Dougal121/Solar/README.md

# Solar
Solar Tracker projects

All these files are supplied as is and are to be used at your own risk.
If in doubt you should seek independent engineering advice as to the suitabilty of desgins before you build anything.
