Dougal121/Solar/Thermal_Controller/ReadMe.md

ESP8266 Controller For Evacuated Tube Thermal Solar Heaters<br>(circa Nov 2020 - 2021 )
===========================================================

Has email warnings and web interface.

15/11/2020 Almost working - hardware a few days off arrival<br>
16/03/2021 The pump relays, Open weather and Email going  <br>
           Yeah Almost fully working - working on modes for predictive boost<br>
27/03/2021 I think it be working... all the components seem almost sorta right<br>
