Dougal121/Solar/ESP8266_Tracker/SecondCut/ReadMe.txt

Second cut with OTA works ok but could be better...

08/05/2019 (in the wee hours)
Assuming I havent broken to many things since my last test this should be close to whats running in the feild and very close to whats running on the spare unit sitting beside me on the sofa
