Dougal121/Solar/(threads)

Thread 1 (2020-06-30):

Try to check standalone esp test

dawidqs, 2020-06-30:
Hi
I got bootloop with 3rd cut esp 8266 code. I'm only preconfigure ssid and password, ESP connect for while to AP, disconnect, do the configure AP for few secs and reboot.

Log with first error:

WiFi connected
IP address: 192.168.043.165
NTP Local UDP port: 2390
Control Local UDP port: 8666
HTTP server started
Fatal exception 9(LoadStoreAlignmentCause):
epc1=0x40215617, epc2=0x00000000, epc3=0x00000000, excvaddr=0x3ffefc6b, depc=0x00000000

Exception (9):
epc1=0x40215617 epc2=0x00000000 epc3=0x00000000 excvaddr=0x3ffefc6b depc=0x00000000

My conf:
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

Dougal121, 2020-07-01:
I assume you have done an "eeprom save" after the first factory reset ?
This is sort of a catch all ... but it should do this on the very first boot ?
If it doesn't connect to your client AP you should be able to access it from the softAP to test and configure everything else ?

Hmm running on 2.7.1   (last time I tested this was 2.4.1)
I will check and see if that is the issue. Have already had another issue with 2.7.1 BUT I know that user is getting past boot as his issue was in the OTA upload.

dawidqs, 2020-07-01:
Hello
Thank you for answer.
I get the email from error on first boot after flashing by arduino ide. I
can't do enything in Web settings during loop, after connect it's pingable
only for few seconds. On 2nd cut this hardware on same settings Web
interface works well.
This is my first steps with this project. I got only ESP from my stuff and
will buy rest items after some tests with it. I may forfeit the led, lcd
displays and gps modules.

Śr., 1 lip 2020, 02:46 użytkownik Dougal Plummer <notifications@github.com>
napisał:

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

Dougal121, 2020-07-02:
YES it will run without everything... ie the bare ESP should be OK
I have a picture with a naked ESP32 board running the code connected to nothing but its inbuilt OLED display (the display is write only so it runs without that as well).

I may need to flash a virgin board to check the results you are seeing with 2.7.1

Stick to the third cut of the code as it is the only one kept up to date. And there are some issues in the older versions that took a lot of time to find and remove.

ans-gw, 2022-06-23:
Hi,
I m trying this new V3 Giune 2022,but got compile error :
exit status 1
'class ESPMail' has no member named 'addBCC'

Page "Email.ino": line 92-94:

if ( String(SMTP.BCC).length() > 5 ){
        WDmail.addBCC(SMTP.BCC );
      }

- I cancel line 92-94(for try) and scetch will compile and upload and run into Esp8266 Nodemcu32.
- I can connect wifi ,access menu ecc.
I dont know which are the conseguence of cancel line  92-94!!!
Please take a look.

Thank you...good job,really.
I actually use Esp32 version wth gyro and Rtc module and all works ok.
Glad to see you fix Noed Emisphere...i load it jesterday and work ok.

-

Dougal121, 2022-06-24:
You need to add the ESPMail lib to your ardudino IDE ?
I will lookup the version number and put details up tonight if time permits

ans-gw, 2022-06-24:
Hi,
I add already Espmail.
Compile error is:
"exit status 1
'class ESPMail' has no member named 'addBCC'"

I google it and i find should be "AddBCC"...instead of "addBCC"...i tryed but get compile error.

If I cancel from Page "Email.ino" line 92-94,sketch compile Ok ,can upload it to Esp8266 Nodemcu.
"if ( String(SMTP.BCC).length() > 5 ){
WDmail.addBCC(SMTP.BCC );
} "

Unfortunatelly,I no have the knowledge,to solve it.

Thank you for help.

ans-gw, 2022-07-03:
> You need to add the ESPMail lib to your ardudino IDE ? I will lookup the version number and put details up tonight if time permits

Now its working fine.Thanks for tip.
Why no have anymre GPIO settint on web interface?
Can you kindly explain wind speed sorce?
0 ADC-A0; 1 Other Tracker; 2 Open weather

Thanks you

ans-gw, 2022-07-04:
Today i was testing the system and I notice a problem:
After a loss of power,Esp8266 rebooted and get Time from Ntp server,so started calculation and turn on 1 Est relay...
but gyro was not installed and this cause East relay never torn off!
Very dangerous...fortunatelly i was testing on the workbench!

ans-gw, 2022-07-05:
......Huoston ,we have a problem!!!
Pin D8 can not be used on My ESP8266 Nodemcu !
If i start power on Esp8266 with Pin D8 connected....Esp will not boot.
If i plug pin D8 after boot ALL is Ok.
How to do?
Have free GPIO10 and GPIO9,but if i try to change here,I have error compile:
Pin was not declared for this scope.
const byte RELAY_XZ_PWM = **D8 to GPIO10**; // PWM 1    Speed North / South     Was the X- S relay  Orange
const byte RELAY_YZ_PWM = D5; // PWM 2    Speed East / West       Was the Y+ W relay  Blue
const byte RELAY_YZ_DIR = D6; // DIR 2    Y+ Y- East / West       Was the Y- E relay  Yellow
const byte RELAY_XZ_DIR = D7; // DIR 1    X+ X-  North / South    Was the X+ N relay  Brown

With Esp32 version was easy,as con change pins from web interface...

Thanks for help.

Dougal121, 2022-07-06:
Sorry been very busy.
Yes system does require sensors and limit switches for travel. In my case these are built into the unit actuators and give another level of protection should the computer go mad.
Yes only some of the pins on the ESP8266 can be used on relay boards... It stops the CPU booting ... Yes use another pin
Ummm to use pin GPIO10  just put in "10" ? The "D" designations don't always work unless your using EXACTLY the branded board.  I often resort to writing a simple blink program to toggle pins then go looking for them with a meter, this checks my declarations.
Yes on the ESP32 I added a this to the web interface but you didn't really get a choice on the ESP8266 as it has only exactly the correct number of pins... esp32 has MORE than enough

Dougal121, 2022-07-06:
I will get back on this shortly but I have to finish some paid work first unfortunately

ans-gw, 2022-07-07:
> I will get back on this shortly but I have to finish some paid work first unfortunately

OK...
I update you,after more tests:
GPIO 10-9-1-3 no one is working.I no understand?
Only D8...if i connect the pin after Esp8266 boot up.
I m changing only in line 92:
92 const byte RELAY_XZ_PWM = D8 to GPIO10; // PWM 1 Speed North / South Was the X- S relay Orange
May be have to change somewhere else?

Thanks for help.

P.s:with Rtc module connected i can see the new pages...ooo...super.

Dougal121, 2022-07-08:
On these lines
const byte RELAY_XZ_PWM = D5; // PWM 1    Speed North / South     Was the X- S relay  Orange
const byte RELAY_YZ_PWM = D6; // PWM 2    Speed East / West       Was the Y+ W relay  Blue
const byte RELAY_YZ_DIR = D7; // DIR 2    Y+ Y- East / West       Was the Y- E relay  Yellow
const byte RELAY_XZ_DIR = D8; // DIR 1    X+ X-  North / South    Was the X+ N relay  Brown
Try replacing all the "D?" with just the port numbers as written on the silkscreen of your board
These "D?" only really make sense if you on a WEMOS D1 R2  or similar board.
If you do a search for "pins_arduino.h" on your computer you will see how it all works... there is a file for every board type

As I said before you can use a blink program to test that the pins are what they say they are

ans-gw, 2022-07-08:
>

My board Pins have D1-D2 ecc as Wemos D1
Im testing all the day...I try with "D" and with pin number...no way.
Something very strange happens:
if i change the "D8"(NORTH) pin number in D9,D10 or GPIO3,GPIO1 or whatever pin,
tracking North South not working at all!!even if i no connect any wire to the pin!
D7 is SOUTH,relay D7 should work even if  i modify D8!?
I suppose D8 is called in some other funcions...I try to check all sketch pages ,but i cant find(i m noob)

The only way scketch working is:turn on Esp8266 with D8 wire unplugged,and plug back after Esp8266 is boot up.
const byte RELAY_XZ_PWM = D7; // PWM 1  SOUTH  Speed North / South     Was the X- S relay  Orange
const byte RELAY_YZ_PWM = D5; // PWM 2  WEST  Speed East / West       Was the Y+ W relay  Blue
const byte RELAY_YZ_DIR = D6; // DIR 2  EAST  Y+ Y- East / West       Was the Y- E relay  Yellow
const byte RELAY_XZ_DIR = D8; // DIR 1  north  X+ X-  North / South    Was the X+ N relay  Brown

This is my file pins_arduinoH in my Arduino folder, library Esp8266 Board V.2.7.1.
#ifndef Pins_Arduino_h
#define Pins_Arduino_h

#define PIN_WIRE_SDA (4)
#define PIN_WIRE_SCL (5)

static const uint8_t SDA = PIN_WIRE_SDA;
static const uint8_t SCL = PIN_WIRE_SCL;

#ifndef LED_BUILTIN
#define LED_BUILTIN 2
#endif
#define LED_BUILTIN_AUX 16

static const uint8_t D0   = 16;
static const uint8_t D1   = 5;
static const uint8_t D2   = 4;
static const uint8_t D3   = 0;
static const uint8_t D4   = 2;
static const uint8_t D5   = 14;
static const uint8_t D6   = 12;
static const uint8_t D7   = 13;
static const uint8_t D8   = 15;
static const uint8_t D9   = 3;
static const uint8_t D10  = 1;
#include "../generic/common.h"
#endif /* Pins_Arduino_h */

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

ans-gw, 2022-07-17:
I got a Wemos D1 R2 ...wow...i was very happy,Solar Tracker V3 sketch,compile and upload smootly......,
but...I cant access Web Interface by NODE Ip address.(the one my router assign  to Esp),
but I can access by CONFIG  NODE Ip Addreess!
I think the problem is: This Esp8266 have a strange behavior,
cant change CONFIG  NODE Ip addres;every time got same address even if i change my router Ip.
I even upload the sketch with Erase Flash + WiFi Setting..no success.
I try to set static  Ip on the scketch,but unsuccessfully.
Please help me to set static Ip for  CONFIG  NODE  Ip Addreess , and CONFIG  NODE Ip Addreess
 in the script.

Thank you very much.

Dougal121, 2022-07-18:
Need to set the static IP and also the correct SSID and password
These are case sensitive
Use the config address to set the main address. Then save the settings in eeprom (in the web interface) , power down and power up again.
BTW what sort of encryption/authentication are you using in the router?   I usually have  WPA/WPA2 +   AES & TKIP

Dougal121, 2022-07-18:
If the signal is a bit weak then you just need to let the system sit till it connects ... this will happen as it retries every minute if it's offline.

OPS I see an issue ... Tracker hasn't acquired that code module yet... (very old code)
I can set all this in my other projects ...
Let me try and fix this tonight ish (maybe) and upload it for you ....
That way you will have option for static IP in the user interface. + the reconnect code

Dougal121, 2022-07-18:
And yes the ESP can be very strange about this...  Sorta gets stuck on one IP address ?
When in doubt I load another project into the board fire it up then load back to the one I want ...

ans-gw, 2022-07-26:
I manage to set a fix Ip.....
I modify Line 451 On TRacker EspTop:
 ghks.MyIPC = IPAddress (192, 168, 3, 150);
After setting up i tested,but I discover that Pin D8 if connected to rele 4 on  cause Wemos D1 R2 no boot!
Same as Esp8266 NodeMcu.
I dont understand,Tracker ESP32 was so easy to use.
Other Pins awailable no have In Wemos D1.
Would be very nice a Esp32 version.
Question:why you delevope the New version for Esp8266 and Not for Esp32?

Thank you for your  time

Dougal121, 2022-08-06:
Ive been working on the ESP8266 version .. will publish when it's all stable again
Yes your wish is on the list

ans-gw, 2022-08-06:
Ok..Thank you very much.
For now solar tracker is working with 1 axix(E/W) from 11 days no problem.
I use Wemos D1 R2.1 and Gyro only.This way all seems to work ok.

Something about calculation N/S:
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

Hour Elevation should be 10.85,not -10.85 !!! ...i no understand

Thank you for jor job.

ans-gw, 2022-10-08:
Hi...you have any updates?
I switch back to Esp32 Genuary 2022 version(v3.3.5-1-g85c43024c)
It s running good...I use Esp32+Gyro only.
Thanks for your time

ans-gw, 2023-03-16:
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

Hello,
i see you update ESP8266 project...do you have any update for Esp32 ?
Thank you

Dougal121, 2023-03-16:
Hi... Only did that update to sync my laptop with github.
Had an issue and thought it might be an update issue...

What time/date and lat log was that picture snapped at ?

ans-gw, 2023-03-16:
Hi...ah ok i see.
Was hoping in a ESP32 new version...because Esp8266 give me pin problems.

I dont remember time/date rrom that pic,so i send today one.
16 March 20:41
Time Zone:7.00
+6.48768902 ; 99.30296326.

Elevation	8.40	(Deg)  ..should be -8.40.The sun still facing South..
Is this related to North Emisfere problem?

Some moths ago you told me have a new Esp32 version more developed...
can you eventually upload or send in private?..so I can test.

One question:
 in Parameter-Minimum Angle N/S  value:
 the first line is SOUTH value  - (in my case -10)
 second line is NORTH value +  (in my case +25)
is this correct?

Thank you very much .

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

Dougal121, 2023-03-18:
Yes just checked, my esp32 version is like 6 months on from github BUT it is broken at present (does not compile).
Need an hour or two to fix it ... I have solved the coding issues just need to splice fragments in.
Otherwise I would send it to you.
I think it has email , alarms, and environmental logging.
Give me a week and I see what I can do.

Dougal121, 2023-03-22:
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
Just ran your numbers on full/real esp32 hardware  (Malaysia?) against the noaa solar calc.
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
All looks about right for equatorial mount (I think)... have I missed a step ?
You need to only check calculations for daylight hours as you do get negative numbers a night.
If you swap mounts remember it only updates calculation on the minute (i.e. 0 seconds )

ans-gw, 2023-05-01:
Hi..sorry for late answer but I was not at home.
Im running equatorial mode,esp32 on my solar tracker(track E/W only,N/S not properly work).
Version is the old one from GitHub.
Im not in Malaysia,but in the last island in Thailand.Name Koh Lipe.
I test again on 27 April 1 Pm...and Elevatation is -7.09!? the sun is clearly facing north,so should be +7.09.
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

I try to test your last Esp32 version,but i got error code : redefinition of 'void i2cScan()'
probably because have I2CSCAN AND i2C-SCAN pages?   !!confused!!

Thanks for helps.

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

Dougal121, 2023-05-02:
I will check what's loaded in the ESP32 section again tonight (time permitting)...
Your location is   +6.48768902 ; 99.30296326.  GMT +7   right ???
I will run the code on hardware again and compare to the web site

ans-gw, 2023-05-02:
> Hi You realize that you can get negatives in the N/S plane if in the tropics depending on the time of year. Amazing pictures can I use this on the project page ?

Ok,you can use it..you the father of the software.-

Noa sun calc for that date tells 2.28....no -7.09  ....i think something wrong in the Calculation or i missing something?
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

ans-gw, 2023-05-02:
I have 1 problem with shadow in the morning...
Tracker start tracking at sunrise (6:11 am) and the lower part of my  panels is on the shadow till 9,30...
would be possible setting a different time than sunset?...so tracker stay parking till 9.30 and after start tracking?

Thank you very much.

Dougal121, 2023-05-02:
Um how does that help.
Is you park angle not shaded ?

On that picture you highlighted the equation of time 2.28  which is not the elevelation. It's an intermediate step in the calculations.
Look at the far right Alt/Az ... compare these to the second from the bottom numbers on the screen of the tracker
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

WOW that is a small island ... Looks like a really nice place to live.

ans-gw, 2023-05-03:
Yes..2.28 not elevation.
I no understand why tracker is not tracking N/S correctly.
-7.09(south) is wrong..the sun is facing North now.
From tracker: azimuth:310.88 /elevation:78.93 and Hour angle:8.54 / Elevation -7.09.
Can be something wrong in calculation?

You can use my tracker  photo..

very small island name Koh Lipe in Thailand.nice place.no have cars.

About parking:
usually I set parking-10(not shaded,and good for wind)..and then  at sunrise tracker start tracking and muve to -30 and here is shaded.
Would be nice if can set the time when the tracker start tracking...sunrise is to early...
9.30 is ok for me...so stay parking -10 till 9.30 and after start tracking and goew to -30.

Thank you very much.

Dougal121, 2023-05-03:
What happens if you change the sign of N/S (X) axis multiplier in the GUI ?

ans-gw, 2023-05-04:
My N/S (X) axis multiplier  is +1..
I try to set -1,and Current Sensor Angle N/S goes from +13 to -13...
elevation still stay negative.

Dougal121, 2023-05-08:
Yes but does it now point the right way

Dougal121, 2023-05-12:
Depends on how you define the axis. if you flip the measurement coordinate system the same target angle will represent the opposite angle.
Hence asking if it moved the right way ? Not did the target angle change.

ans-gw, 2023-05-16:
No,is not muving in the right direction.

ans-gw, 2023-07-01:
I was testing,and I think,perhaps, i found the solution!?
I modify line 841 and 843 from:
      tv.sunX = abs(tv.latitude) + decl ;
      }else{
      tv.sunX = abs(tv.latitude) - decl ;
to:
      tv.sunX = abs(tv.latitude) - decl ;
      }else{
      tv.sunX = abs(tv.latitude) + decl ;

Elevation/Target angle swap from -16.69 to + 29.67:this is good,tracker is now facing To North,
but I am confused:I was expecting swap from -16.69 to + 16.69...not +29.67.
Why? Can you take a look please?

P.s:I am using the latest Esp32 Tracker release.(it still have the error tracking for North emisfere).
And i had to cancel "i2C_SCAN" from the folder and keep only "I2CSCAN",otherwise not compile.
Is this correct?I install the program and test in the bench and all look fine!

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

ans-gw, 2023-08-09:
Hi,
van you explain how to set wind sensor?
I cant change the pins on Adc page!? if set go back to pin 2?!
what should set as "Mult" , "Ofs".,"Units".
Thank you for help.

Dougal121, 2023-08-17:
I've just been updating all this...
Units is the SI unit for display ... see you wind senor specs/cal figures

The Ofs is the easiest as you can use the zero cal button to set it --- press this when you have zero quantity of wind for example . BUT you need to have the Mult set first.

Mult is the factor to get from ADC counts to Volts and then to your calibrated units..
This depends on how you setup things like your potential divider and the volts per SI unit of the sensor.

You trigger parking by setting an alarm action for it. One alarm to go into park at greater than the wind speed and one to come out at under a wind speed.

ans-gw, 2023-08-25:
I m testing..
now adc pin setting is working ..
i m using wind sensor 0-30 KmH ,0-5 Volt.
I try with zeo cal and devider 6..look like wind speed is quite correct...
not sure 100%...shuold test with separate anemomether tester.

...working in progress
still not test alarm and emails..

good job
thank you

ans-gw, 2023-08-31:
Hi,
Gyro and RTC are working correctly,but i see I2C scan page dont detect Gyro and 2 of 4 entry of RTC module.

Please take a look.

Thank you
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

Dougal121, 2023-09-03:
press the "save active configuration"  then save settings to eeprom on the main page.. will clean up the page. Tells the program what is normal.
You can then alarm on things when they go missing...

Dougal121, 2023-09-03:
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
should look something like this if fully kitted out

Dougal121, 2023-09-03:
The ADC stuff is way more generic now
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

ans-gw, 2023-09-03:
> 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 should look something like this if fully kitted out

Hi,
yes,i see...all ok now.
Thanks

Ps:
I sent you a private email on 19 August...can you please check it?
may be goes to spam folder.
Thank you

Vowa1982, 2024-03-20:
версия за 2022 года 6 месяца загружаемая А вот версия 2023 года 8 месяца уви не компилирует ошибка i2C_SCAN и NTP

Vowa1982, 2024-04-02:
у мене есть пита[code]

void i2cScan() {
  uint8_t i, address, error;
  uint8_t first = 0x03 ;
  uint8_t last = 0x77 ;
  char buff[10];

  SendHTTPHeader();

  server.sendContent(F("<a href='/'>Home</a><br>")) ; 
  server.sendContent(F("<a href='/scan'>Rescan</a><br><br>")) ; 

  server.sendContent(F("<center><b>I2C Bus Scan</b><br><table border=1 title='I2C Bus Scan'><tr><th>.</th>"));
 // table header
  for (i = 0; i < 16; i++) {
    server.sendContent("<th>"+String(i,HEX)+"</th>");
  }
  server.sendContent(F("</tr>"));

  // table body
  // addresses 0x00 through 0x77
  for (address = 0; address <= 119; address++) {
    if (address % 16 == 0) {
      server.sendContent(F("<tr>"));
      server.sendContent("<td><b>"+String((address & 0xF0),HEX)+"</b></td>");
    }
    if (address >= first && address <= last) {
      Wire.beginTransmission(address);
      error = Wire.endTransmission();
      if (error == 0) {
        // device found
        server.sendContent("<td bgcolor='lime'>"+String((address),HEX)+"</td>");
      } else if (error == 4) {
        // other error
        server.sendContent(F("<td bgcolor='red'>XX</td>"));
      } else {
        // error = 2: received NACK on transmit of address
        // error = 3: received NACK on transmit of data
        server.sendContent(F("<td align=center>--</td>"));
      }
    } else {
      server.sendContent(F("<td align=center>.</td>"));
    }
    if (address % 16 == 15) {
      server.sendContent(F("</tr>"));
    }
  }
  server.sendContent(F("</tr></table></body></html>\r\n"));
}

[/code]ння

ans-gw, 2024-09-24:
> The ADC stuff is way more generic now ![image](https://private-user-images.githubusercontent.com/5316556/265258225-deebbee6-fed3-41f2-9e61-8491d67a5bba.png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)

Hi Dougal,wind parking seems not working for me
I done all the setting,set alarm, but panel dont go to wind park.
May be I miss something?!
Is wind parking vorking for you?
Can you please take a look?

Thank you very much
