Dougal121/Solar/Hardware_Design/Solar Tracker 2016 170326_Solar Panels.pdf

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

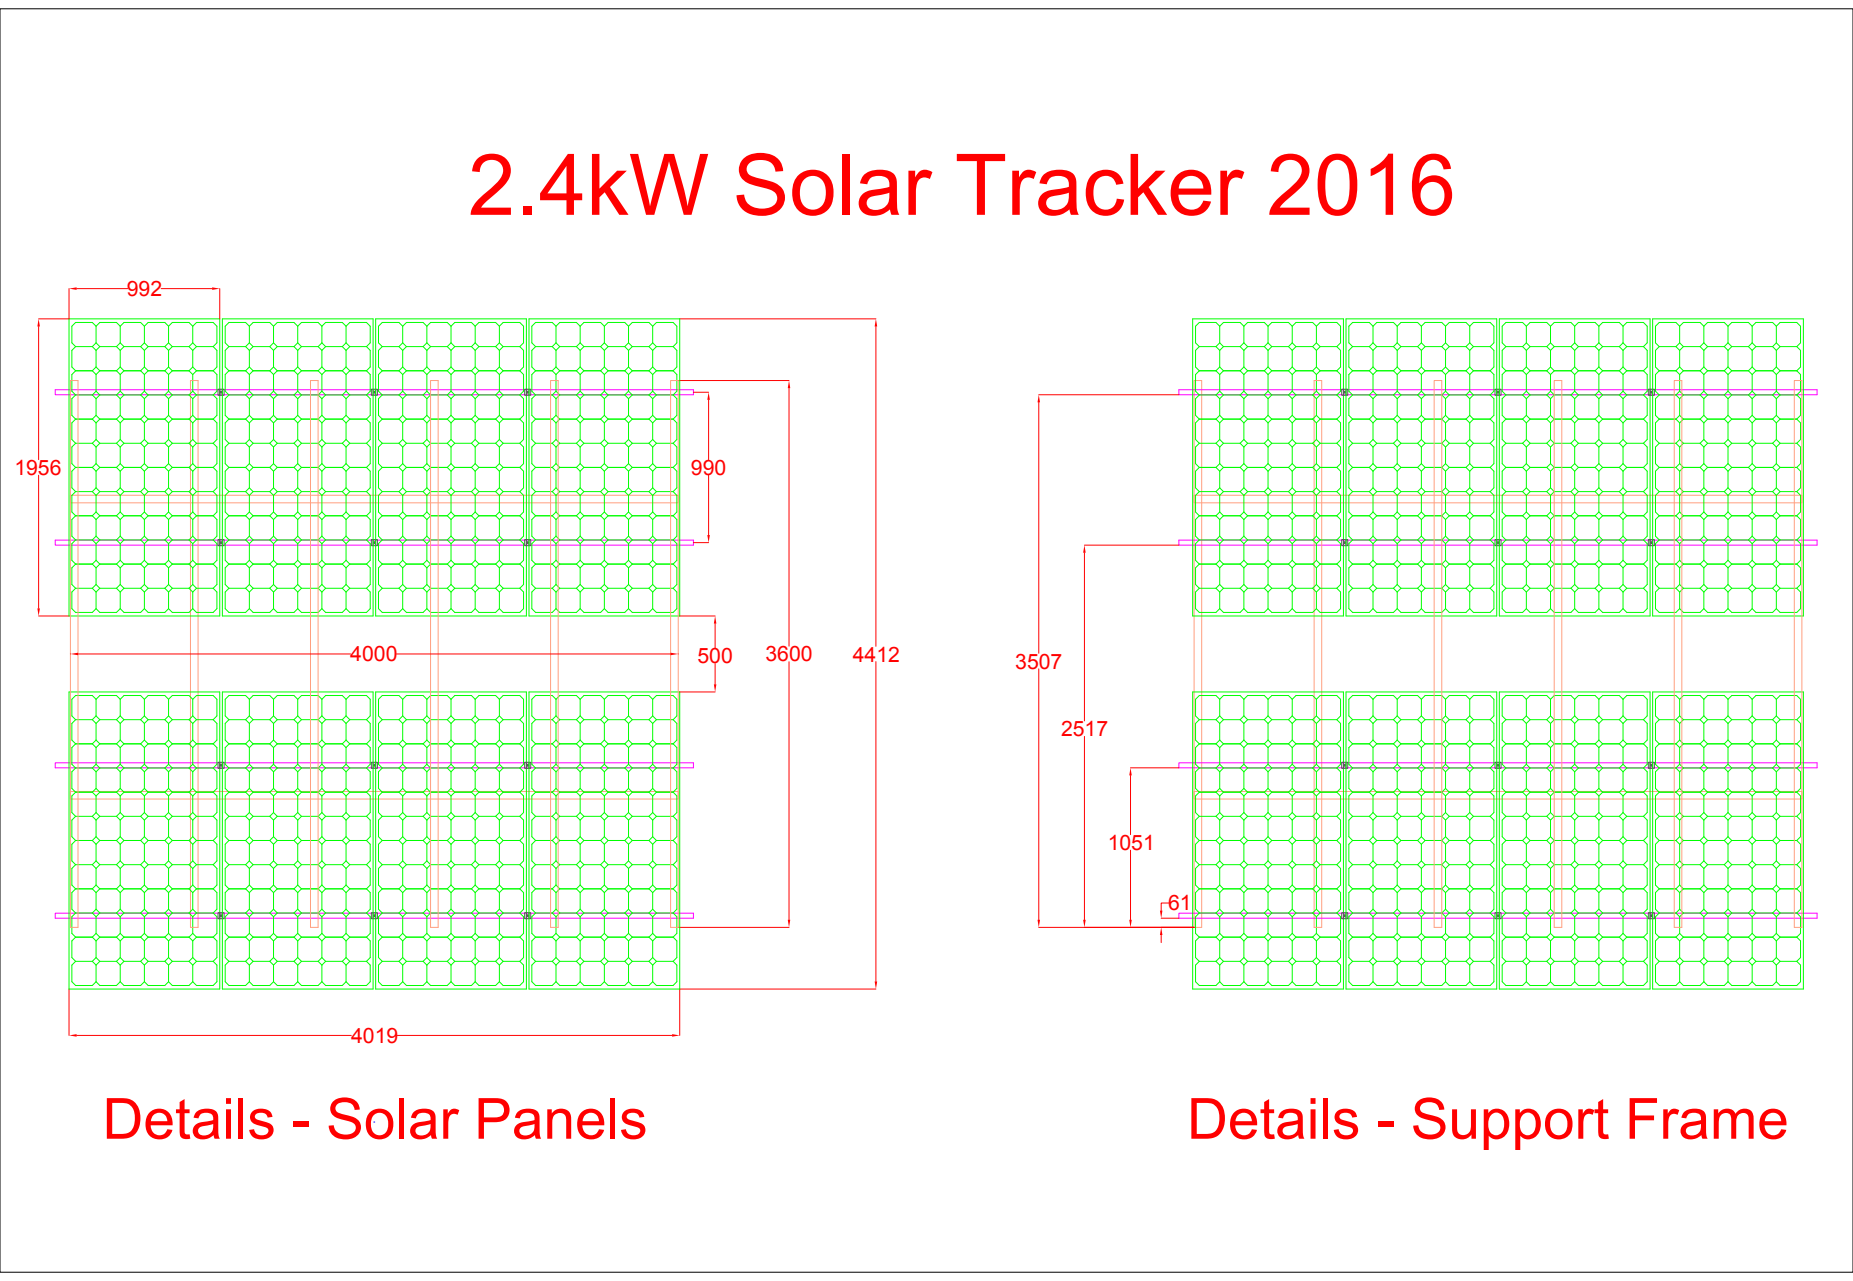
[picture p3: page 1]
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
