Dougal121/Solar/ESP8266_Tracker/ThridCut/i2C_SCAN.ino

void i2cScan() {
  uint8_t i, address, error;
  uint8_t first = 0x03 ; 
  uint8_t last = 0x77 ;
  char buff[10];
  String message ;
  SendHTTPHeader();

  message += F("<a href='/'>Home</a><br>") ;         
  message += F("<a href='/scan'>Rescan</a><br><br>") ;         

  message += F("<center><b>I2C Bus Scan</b><br><table border=1 title='I2C Bus Scan'><tr><th>.</th>");
 // table header
  for (i = 0; i < 16; i++) {
    message += "<th>"+String(i,HEX)+"</th>";
  }
  message += F("</tr>");
  
  // table body
  // addresses 0x00 through 0x77
  for (address = 0; address <= 119; address++) {
    if (address % 16 == 0) {
      message += F("<tr>");
      message += "<td><b>"+String((address & 0xF0),HEX)+"</b></td>";
    }
    if (address >= first && address <= last) {
      Wire.beginTransmission(address);
      error = Wire.endTransmission();
      if (error == 0) {
        // device found
        message += "<td bgcolor='lime'>"+String((address),HEX)+"</td>";
      } else if (error == 4) {
        // other error
        message += F("<td bgcolor='red'>XX</td>");
      } else {
        // error = 2: received NACK on transmit of address
        // error = 3: received NACK on transmit of data
        message += F("<td align=center>--</td>");
      }
    } else {
      message += F("<td align=center>.</td>");
    }
    if (address % 16 == 15) {
      message += F("</tr>");
    }
  }
  message += F("</tr></table></body></html>\r\n");
  server.sendContent(message) ;
  message = "" ;
}
