Dougal121/Solar/(commit log)

2019-06-29 Fixed issue I caused on the relay output / pwm
    Missed by "this much" chief
    [Relay_HSwitch.ino, TRACKER_ESP8266_TOP.ino, UDP_CTRL.ino, WEB_MAIN.ino]
2020-03-08 First Cut Upload Minus the BackinThebox.ino
2020-05-09 Add files via upload
    Auto switch footer links on wiffi connected property
2020-06-13 Add files via upload
    Home stuff wrong but now right ish
    [Relay_HSwitch.ino, TRACKER_ESP32_TOP.ino]
2022-02-05 Add files via upload
    Small but much needed fix for northern hemisphere
    [TRACKER_ESP8266_TOP.ino]
2022-06-07 Add files via upload
    This is a huge update.
    Email alarms...
    Wind sensor, parking and distribution to other trackers
    Changed pages so they transmit less but bigger packets
2023-03-14 Add files via upload
    God knows why but these are not current ?
2023-03-26 Add files via upload
    Compiles but not tested yet.
    Lots of work on the GUI.
    Lots of extra stuff like provisioning for power saving.
    Data logging almost there
2023-08-13 Add files via upload
    ADC and wind parking as well as some work on data logging
2023-08-17 Delete presure.ino
    swapped to new library and dont use this any more in ESP32 version
